fagnerlirya/ServoController/Documentacao/ServoControllerRelatorio.pdf

# AUTOR: FAGNER LIRYA

# ECAD: ALTIUM DESIGNER V16.05

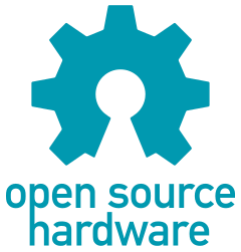
[picture p2: figure]

# PROJETO: SERVO CONTROLLER VERSÃO: 1.0 DATA: ABRIL/2020

# Sumário

# Breve Descrição do Projeto | 1

# Diagrama de Blocos | 2

# Esquemático Folha 1: Top View | 3

# Esquemático Folha 2: Microcontrolador | 4

# Esquemático Folha 3: Alimentação | 5

# Esquemático Folha 4: Servo Driver | 6

# Esquemático Folha 5: Botões e LED’s | 7

# PCB: Visão em 3D | 8

# PCB: Top e Bottom 3D | 9

# PCB: Top e Bottom Layers | 10

# PCB: Top Silkscreen e Bottom Silkscreen | 11

# PCB: Desenho Mecânico | 12

# PCB: Guia de Montagem | 13

# BOM | 14

# Referências | 15

1

# Projeto: Servo Controller Autor: Fagner Lirya Abril/2020

# BREVE DESCRIÇÃO DO PROJETO

Este é um projeto de uma placa para controle de até 16 servo-motores desenvolvida no software "Altium Designer" baseado no Arduíno Uno e no Módulo PCA9685. A placa pode ser programada pela "Arduino IDE", onde ela é reconhecida como "Arduino UNO". O driver para os servo-motores é baseado no Módulo PCA9685, que recebe via protocolo I2C a posição de cada servo. A placa também possuí os conectores padrão Arduíno, podendo desta forma utilizar vários shlieds disponíveis no mercado.

# CONSIDERAÇÕES DE PROJETO

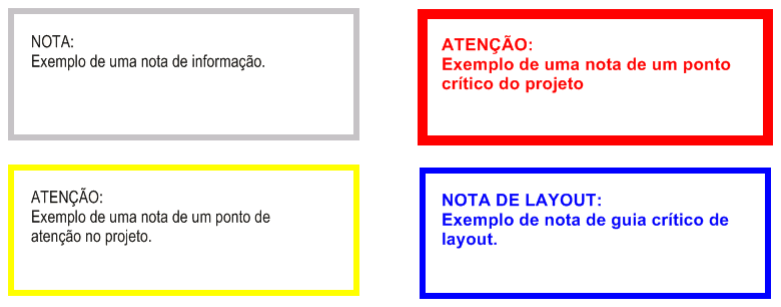
[picture p3: figure]

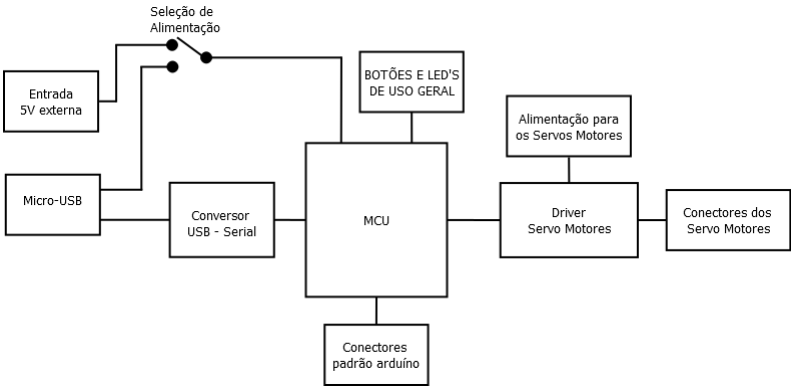
[picture p4: figure]

2

# Autor: Fagner Lirya Abril/2020

# DIAGRAMA DE BLOCOS

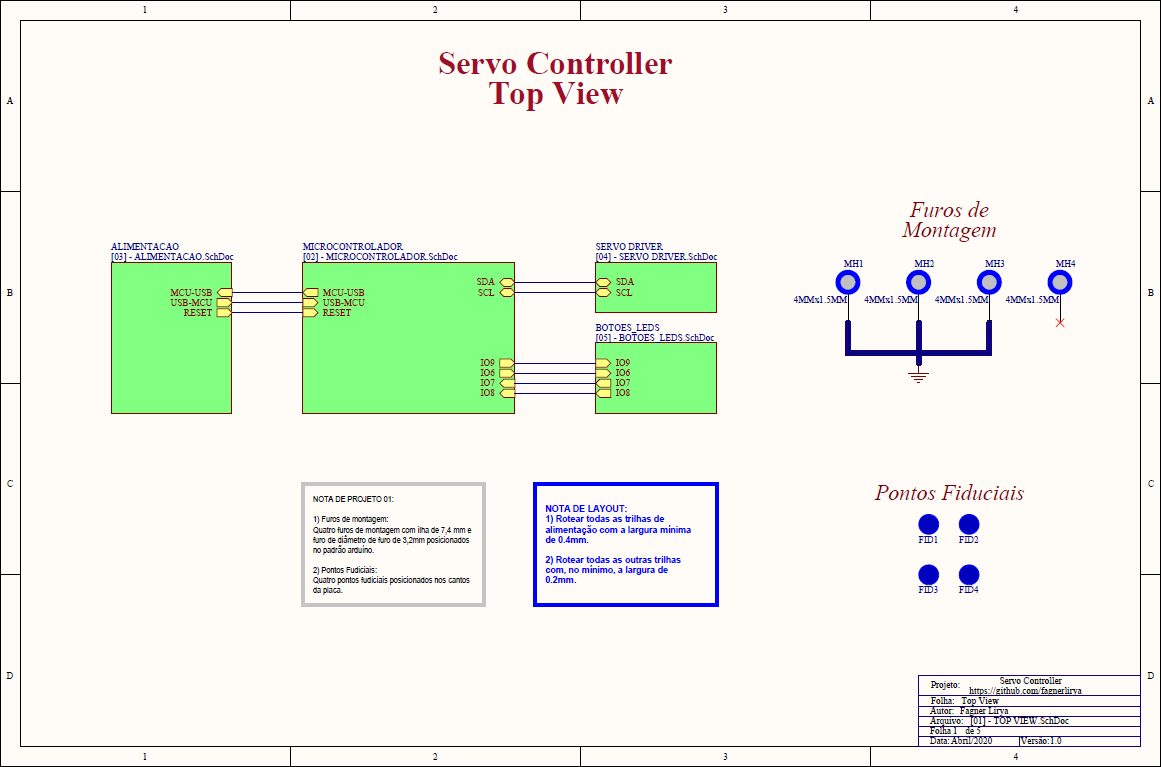
[picture p5: figure]

3

# Autor: Fagner Lirya Abril/2020

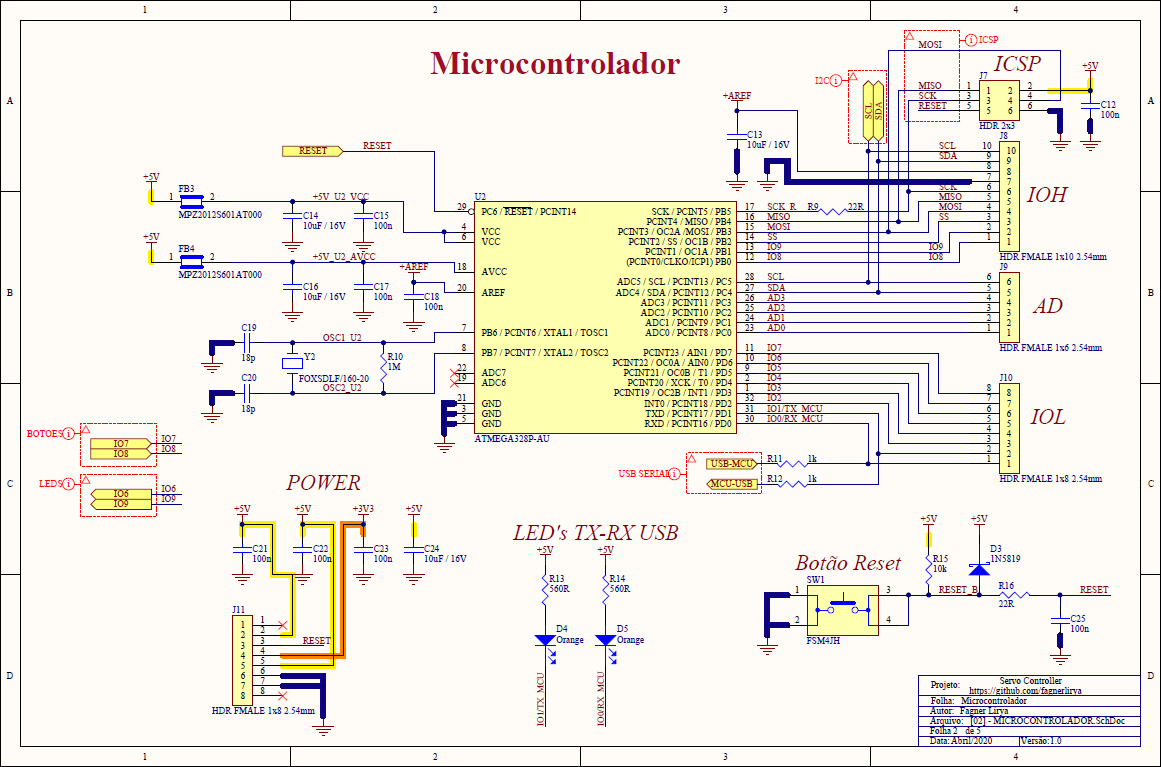
[picture p6: figure]

4

# Autor: Fagner Lirya Abril/2020

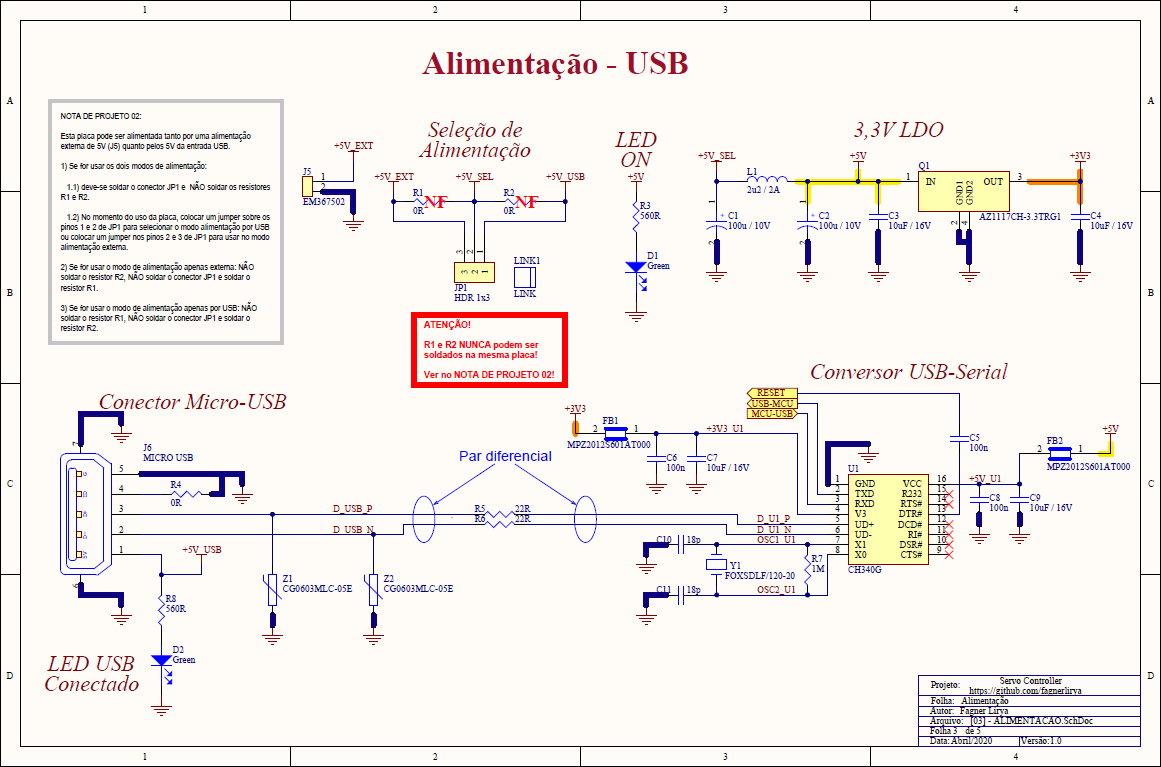
[picture p7: figure]

5

# Autor: Fagner Lirya Abril/2020

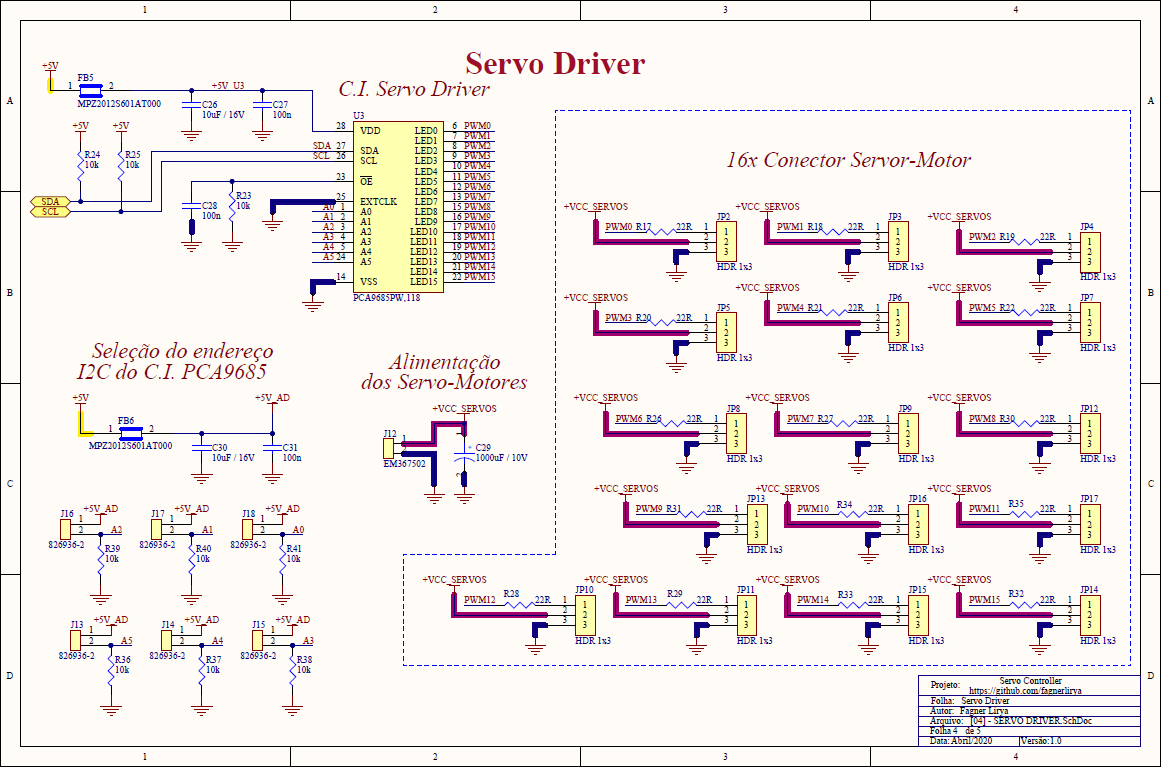
[picture p8: figure]

6

# Autor: Fagner Lirya Abril/2020

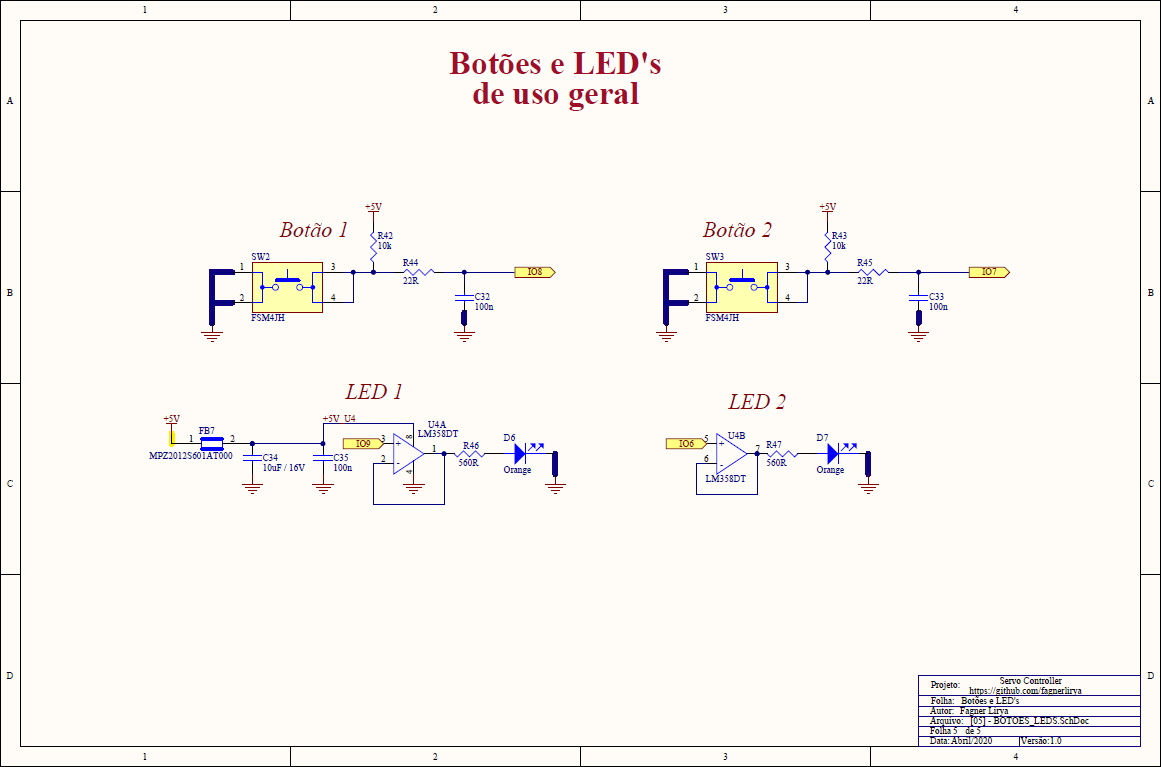
[picture p9: figure]

7

# Autor: Fagner Lirya Abril/2020

8

# Autor: Fagner Lirya Abril/2020

# VISÃO DA PLACA EM 3D

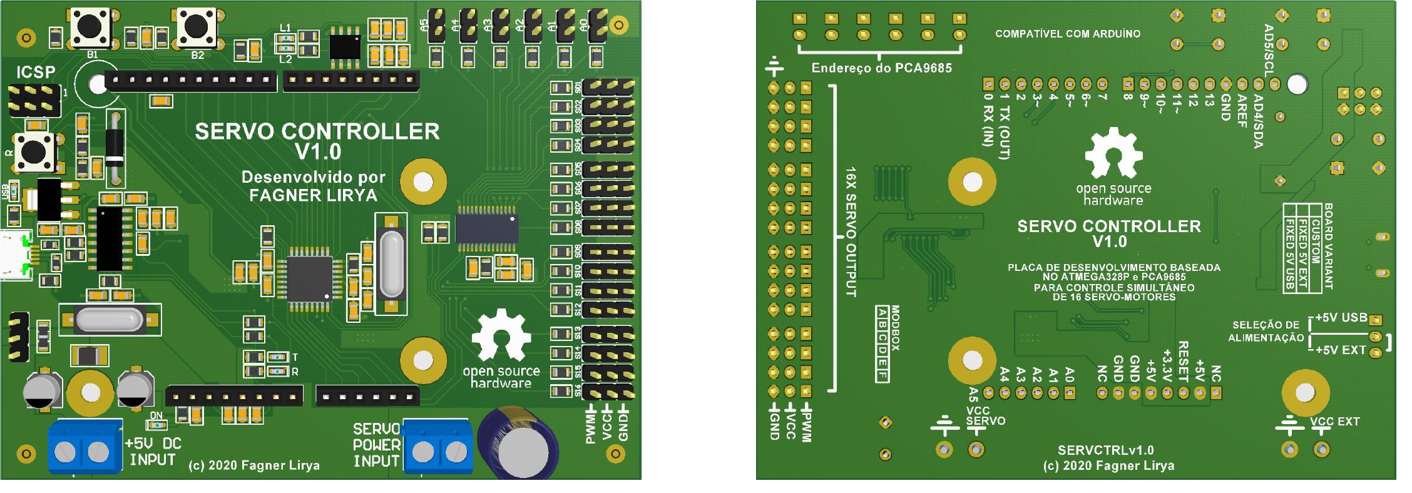
[picture p10: figure]

9

# Autor: Fagner Lirya Abril/2020

# TOP E BOTTOM 3D

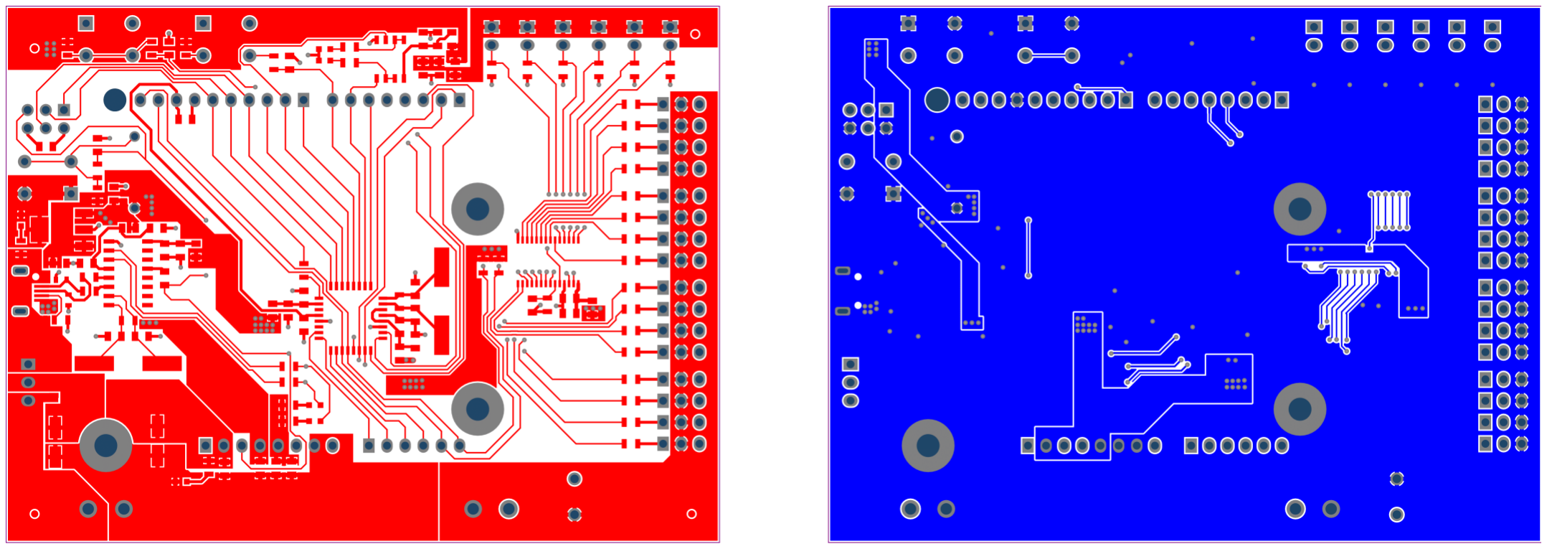
[picture p11: figure]

10

# Autor: Fagner Lirya Abril/2020

# TOP E BOTTOM LAYERS

TOP LAYER | BOTTOM LAYER

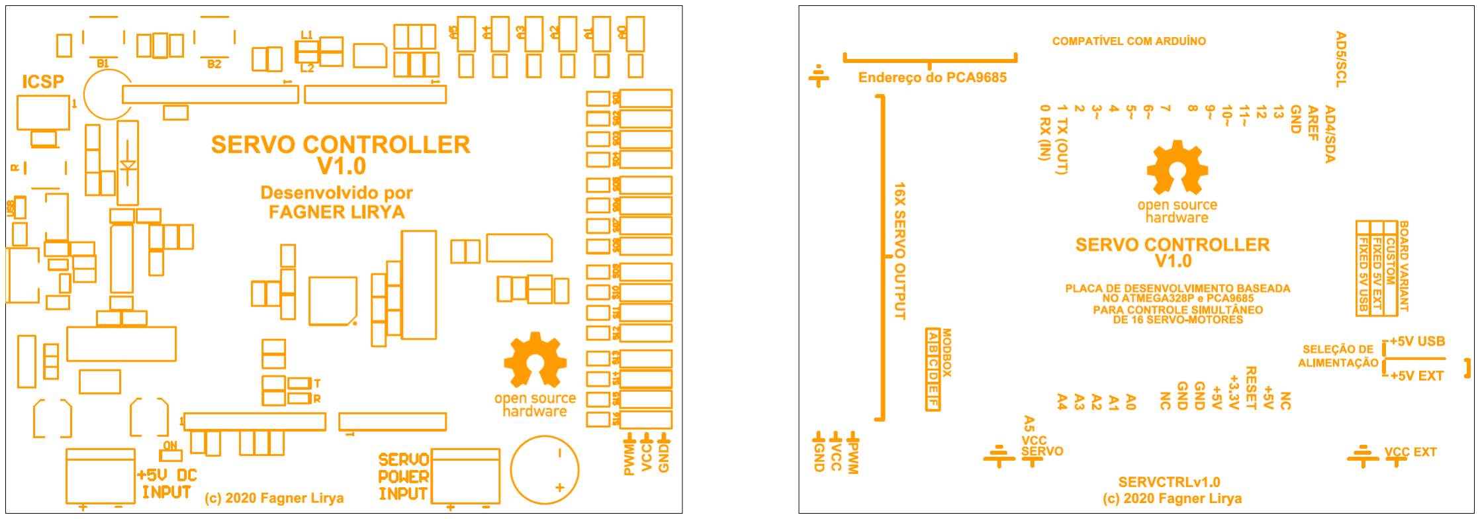
[picture p12: figure]

11

# Autor: Fagner Lirya Abril/2020

# TOP E BOTTOM SILKSCREEN LAYERS

TOP SILKSCREEN | BOTTOM SILKSCREEN

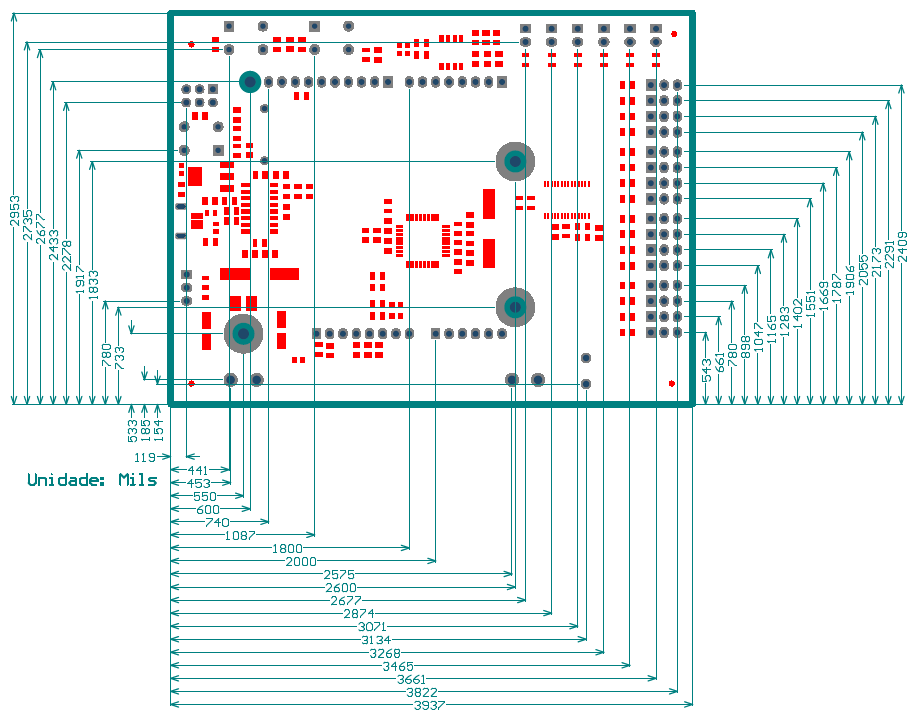
[picture p13: figure]

12

# Autor: Fagner Lirya Abril/2020

# DESENHO DE MECÂNICO

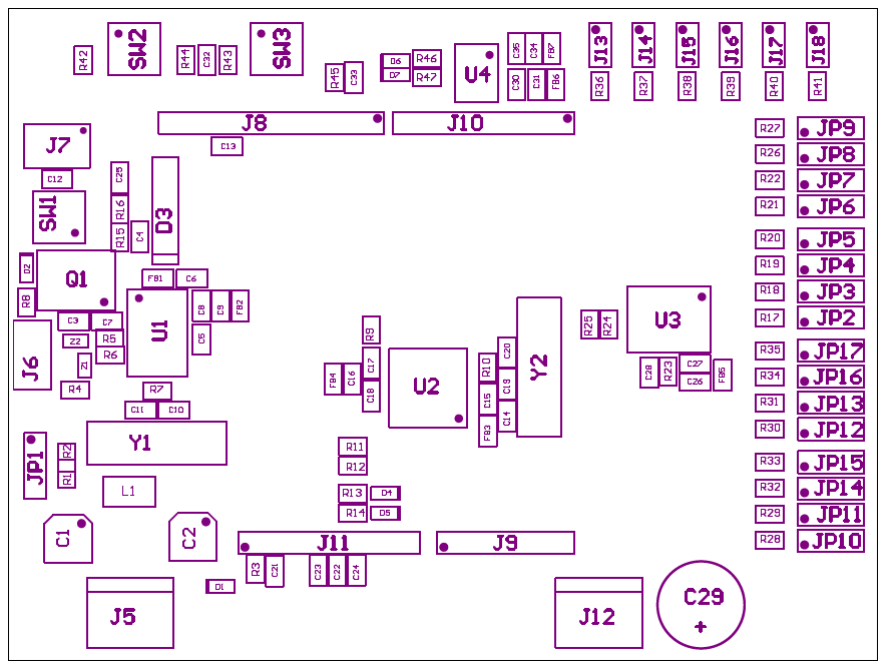
[picture p14: figure]

13

# Autor: Fagner Lirya Abril/2020

# GUIA DE MONTAGEM

14

# Autor: Fagner Lirya Abril/2020

# | Designator | Quantidade | Descrição | Package / Case | Categoria | Manufacturer Part Number

1 | C1, C2 | 2 | CAP ALUM 100UF 20% 10V SMD | Radial, Can - SMD | Capacitors | EEE-1AA101WR
2 | C3, C4, C7, C9, C13, C14, C16, C24, C26, C30, C34 | 11 | CAP CER 10UF 16V X5R 0805 | 0805 (2012 Metric) | Capacitors | C2012X5R1C106M125AC
3 | C5, C6, C8, C12, C15, C17, C18, C21, C22, C23, C25, C27, C28, C31, C32, C33, C35 | 17 | CAP CER 0.1UF 50V X7R 0805 | 0805 (2012 Metric) | Capacitors | C2012X7R1H104K085AA
4 | C10, C11, C19, C20 | 4 | CAP CER 18PF 50V NP0 0805 | 0805 (2012 Metric) | Capacitors | C0805C180J5GACTU
5 | C29 | 1 | Aluminum Electrolytic Capacitors - Leaded 10volts 1000uF 10X16 | PTH | Aluminum Electrolytic Capacitors -Leaded | EKZE100ELL102MJ16S
6 | D1, D2 | 2 | LED GREEN DIFFUSED 0603 SMD | 0603 (1608 Metric) | Optoelectronics | LG L29K-G2J1-24-Z
7 | D3 | 1 | Schottky Diodes & Rectifiers Schottky Barrier | DO-41 | Schottky Diodes & Rectifiers | 1N5819
8 | D4, D5, D6, D7 | 4 | LED ORANGE DIFFUSED 0603 SMD | 0603 (1608 Metric) | Optoelectronics | LO L29K-H2K1-24-Z
9 | FB1, FB2, FB3, FB4, FB5, FB6, FB7 | 7 | FERRITE CHIP BEAD 600 OHM SMD | 0805 (2012 Metric) | Filters | MPZ2012S601AT000
10 | J5, J12 | 2 | Fixed Terminal Blocks EURO (MA311-50002) TERM | PTH | Fixed Terminal Blocks | EM367502
11 | J6 | 1 | CONN USB MICRO B RECPT SMT R/A | PTH | Connectors, Interconnects | ML-01
12 | J7 | 1 | CONN HEADER 6POS .100 STR 30AU | PTH | Connectors, Interconnects | 67997-106HLF
13 | J8 | 1 | 10-WAY SIL VERT SOCKET L/FREE | PTH | Connectors, Interconnects | M20-7821046
14 | J9 | 1 | 06-WAY SIL VERT SOCKET L/FREE | PTH | Connectors, Interconnects | M20-7820646
15 | J10, J11 | 2 | 08-WAY SIL VERT SOCKET L/FREE | PTH | Connectors, Interconnects | M20-7820842
16 | J13, J14, J15, J16, J17, J18 | 6 | Headers & Wire Housings 2P SINGLE ROW | PTH | Headers & Wire Housings | 826936-2
17 | JP1, JP2, JP3, JP4, JP5, JP6, JP7, JP8, JP9, JP10, JP11, JP12, JP13, JP14, JP15, JP16, JP17 | 17 | BERGSTIK II .100" SR STRAIGHT | PTH | Connectors, Interconnects | 68000-103HLF
18 | L1 | 1 | FIXED IND 2.2UH 2A 80 MOHM SMD | 1210 (3225 Metric) | Inductors, Coils, Chokes | L1210R2R2MDWIT
19 | LINK1 | 1 | CONN JUMPER SHORTING .100" GOLD | --- | Connectors, Interconnects | QPC02SXGN-RC
20 | Q1 | 1 | LDO Voltage Regulators LDO BJT HiCurr 1.15V at 1A | SOT-223-3 | LDO Voltage Regulators | AZ1117CH-3.3TRG1
21 | R1, R2, R4 | 3 | RES SMD 0.0 OHM JUMPER 1/8W 0805 | 0805 (2012 Metric) | Resistors | RC0805JR-070RL
22 | R3, R8, R13, R14, R46, R47 | 6 | RES SMD 560 OHM 1% 1/8W 0805 | 0805 (2012 Metric) | Resistors | RC0805FR-07560RL
23 | R5, R6, R9, R16, R17, R18, R19, R20, R21, R22, R26, R27, R28, R29, R30, R31, R32, R33, R34, R35, R44, R45 | 22 | RES SMD 22 OHM 1% 1/8W 0805 | 0805 (2012 Metric) | Resistors | RC0805FR-0722RL
24 | R7, R10 | 2 | RES SMD 1M OHM 1% 1/8W 0805 | 0805 (2012 Metric) | Resistors | RC0805FR-071ML
25 | R11, R12 | 2 | RES SMD 1K OHM 1% 1/8W 0805 | 0805 (2012 Metric) | Resistors | RC0805FR-071KL
26 | R15, R23, R24, R25, R36, R37, R38, R39, R40, R41, R42, R43 | 12 | RES SMD 10K OHM 1% 1/8W 0805 | 0805 (2012 Metric) | Resistors | RC0805FR-0710KL
27 | SW1, SW2, SW3 | 3 | Tactile Sw itches SPST OFF-(ON) Round pushbutton | PTH | Tactile Sw itches | FSM4JH
28 | U1 | 1 | USB bus adapters | SO-16 | USB bus adapters | CH340G
29 | U2 | 1 | 8-bit Microcontrollers - MCU 32KB In-system Flash 20MHz 1.8V-5.5V | TQFP-32 | 8-bit Microcontrollers - MCU | ATMEGA328P-AU
30 | U3 | 1 | LED Display Drivers I2C Bus LED Controller 28-Pin | SSOP-28 | LED Display Drivers | PCA9685PW,118
31 | U4 | 1 | Operational Amplifiers - Op Amps Dual Low Pow er | SO-8 | Operational Amplifiers - Op Amps | LM358DT
32 | Y1 | 1 | Crystals 12MHz 20pF | HC-49/US | Crystals | FOXSDLF/120-20
33 | Y2 | 1 | Crystals 16MHz 20pF | HC-49/US | Crystals | FOXSDLF/160-20
34 | Z1, Z2 | 2 | VARISTOR 0603 | 0603 (1608 Metric) | Circuit Protection | CG0603MLC-05E

# Lista de Componentes

# Projeto: Servo Control - Versão 1.0 - Abril/2020

15

# Autor: Fagner Lirya Abril/2020

# REFERÊNCIAS

- Repositório com o projeto completo: https://github.com/fagnerlirya/ServoController.
- Versão Free Trial do software Altium Designer: https://www.altium.com/free-trials.
- Biblioteca para o PCA9685: https://github.com/adafruit/Adafruit-PWM-Servo-Driver-Library.
- Arduino IDE: https://www.arduino.cc/.
