fagnerlirya/ServoController/(list of files, drawings)

Other design files:
Arquivos-fontes/[01] - TOP VIEW.SchDoc
Arquivos-fontes/[02] - MICROCONTROLADOR.SchDoc
Arquivos-fontes/[03] - ALIMENTACAO.SchDoc
Arquivos-fontes/[04] - SERVO DRIVER.SchDoc
Arquivos-fontes/[05] - BOTOES_LEDS.SchDoc
Arquivos-fontes/Servo_Control_Lib.PcbLib
Arquivos-fontes/Servo_Control_Lib.SchLib
Arquivos-fontes/ServoControl.PrjPcb
