fagnerlirya/ServoController/(commit log)

2020-04-30 Primeira versão do Servo Controller
    [ServoControl.PrjPcb, Servo_Control_Lib.PcbLib, Servo_Control_Lib.SchLib, [01] - TOP VIEW.SchDoc, [02] - MICROCONTROLADOR.SchDoc, [03] - ALIMENTACAO.SchDoc, [04] - SERVO DRIVER.SchDoc, [05] - BOTOES_LEDS.SchDoc]
2020-05-01 Alteração na estrutura das pastas, Adicionado os arquivos de produção e o relatório PDF
    [BOM.xlsx, ServoControl.PrjPcb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]
